chregu82/Atari2600Board/OrigJrBoard/JrBoard/JrBoard.kicad_pcb

## KiCad design OrigJrBoard/JrBoard/JrBoard.kicad_pcb (2021-01-26)

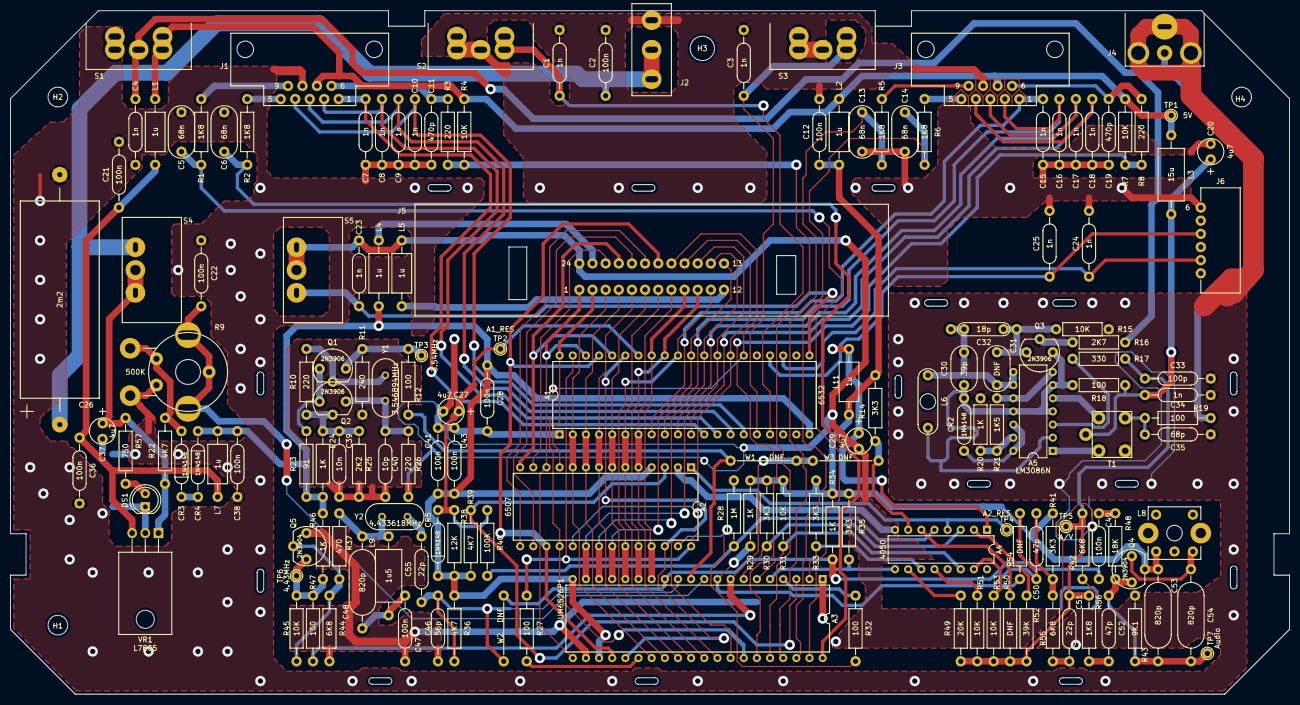
[picture p3: board JrBoard.kicad_pcb from above]

Board: 2 copper layers, 247.0 x 132.0 mm, 162 parts (0 on the bottom side), 115 nets.

Parts:
A1: 6532; DIP-40_W15.24mm
A2: 6507; DIP-28_W15.24mm
A3: UM6526P1; DIP-40_W15.24mm
A4: 4050; DIP-16_W7.62mm
A5: LM3086N; DIP-14_W7.62mm
C1, C3, C4, C7, C8, C9, C10, C15, C16, C17, C18, C23, C24, C25, C34: 1n; C_leg_small
C2, C12, C21, C22, C28, C36, C38, C41, C43, C47, C49: 100n; C_leg_small
C5, C6, C13, C14: 68n; C_oval_big
C11, C19: 470p; C_leg_small
C20, C27, C29, C37: 4u7; CP_small
C26: 2m2; CP_big
C30: 39p; C_oval_small
C31: DNF; C_oval_small
C32: 18p; C_4hole
C33: 100p; C_leg_small
C35: 68p; C_leg_small
C39: 10n; C_leg_small
C40: 10p; C_leg_small
C46: 56p; C_leg_small
C48, C53, C54: 820p; C_leg_big
C50, C52: 47p; C_leg_small
C51, C55: 22p; C_leg_small
CR2: 1N4148; Diode_short
CR3, CR4, CR5: 1N4148; Diode
DS1: LED RED; LED_D5.0mm_Clear
H1, H2, H4: MountingHole; HoleEdge
H3: MountingHole; HoleTop
J1: Joy left; Joystick_conn
J2: DC In; DC_IN
J3: Joy right; Joystick_conn
J4: RF_Out
J5: Cartridge Connector; Cartridge
J6: SEL / RES; Button_conn
L1, L2, L4, L5, L7, L11: 1u; L_small
L3: 15u; L_big
L6: 0..1u; L_var_2pin
L8: 0..4u; L_var_5pin
L9: 1u5; L_big
Q1, Q2, Q3: 2N3906; TR_TO92
Q4, Q5: 2N3904; TR_TO92
R1, R2, R5, R6, R56: 1K8; R0.5Inch
R3, R8, R10, R26: 220; R0.5Inch
R4, R7, R31, R45, R51, R53: 10K; R0.5Inch
R9: 500K; R_Var
R11: 240; R0.5Inch
R12, R19, R27, R32, R47: 100; R0.5Inch
R14, R30, R33, R35, R41: 3K3; R0.5Inch
R15: 10K; R_small
R16: 2K7; R_small
R17: 330; R_small
R18: 100; R_small
R20: 1K; R_small
R21: 1K5; R_small
R22, R36, R39: 4K7; R0.5Inch
R23: 91; R0.5Inch
R24, R29, R34, R46: 1K; R0.5Inch
R25: 2K2; R0.5Inch
R28: 1M; R0.5Inch
R37: 470; R0.5Inch
R38: 12K; R0.5Inch
R40: 100K; R0.5Inch
R42, R44, R55: 6K8; R0.5Inch
R43: 9K1; R0.5Inch
R48: 18K; R0.5Inch
R49: 20K; R0.5Inch
R50, R54: DNF; R0.5Inch
R52: 39K; R0.5Inch
R57: 750; R0.5Inch
S1: CH3/4; Switch_rear
S2: DIFF_L; Switch_rear
S3: DIFF_R; Switch_rear
S4: POWER_SW; Switch_top
S5: COLOR_SW; Switch_top
T1: TV_Trans; Atari_TV_Trans
TP1: 5V; TestPoint_THTPad_D2.0mm_Drill1.0mm
TP2: A1_RES; TestPoint_THTPad_D2.0mm_Drill1.0mm
TP3: 3.54MHz; TestPoint_THTPad_D2.0mm_Drill1.0mm
TP4: A2_RES; TestPoint_THTPad_D2.0mm_Drill1.0mm
TP5: A/V; TestPoint_THTPad_D2.0mm_Drill1.0mm
TP6: 4.43MHz; TestPoint_THTPad_D2.0mm_Drill1.0mm
TP7: Audio; TestPoint_THTPad_D2.0mm_Drill1.0mm
VR1: L7805; TO-220-3_Horizontal_TabDown
W1, W2, W3: DNF; Wire
Y1: 3.546894MHz; Crystal_HC18-U_Vertical
Y2: 4.433618MHz; Crystal_HC18-U_Vertical

Connections:
+5V: J1.7, J3.7, L1.1, L2.1, L3.1, R4.2, R7.2, S1.3, TP1.1
+5VA: C12.1, C53.1, L2.2, L8.1, L11.1, Q4.2, R14.1, R29.1, R30.1, R31.1, R33.1, R34.1, R35.1, R41.1
/A0: A1.7, A2.5, A3.32, J5.8
/A1: A1.6, A2.6, A3.31, J5.7
/A1_R: A1.34, C27.1, CR5.2, R38.2, R40.1, TP2.1
/A2: A1.5, A2.7, A3.30, J5.6
/A2_R: A2.1, A4.4, R28.2, TP4.1
/A3: A1.4, A2.8, A3.29, J5.5
/A4: A1.3, A2.9, A3.28, J5.4
/A5: A1.2, A2.10, A3.27, J5.3
/A6: A1.40, A2.11, J5.2
/A7: A1.38, A2.12, A3.21, J5.1
/A8: A2.13, J5.22
/A9: A1.36, A2.14, J5.21
/A10: A2.15, J5.19
/A11: A2.16, J5.20
/A12: A1.37, A2.17, A3.24, J5.18
/AUD: A3.13, C49.2, R34.2, W2.1
/COL: A3.9, C50.2, R29.2, R54.1
/CSYNC: A3.2, A4.11, R33.2
/D0: A1.33, A2.25, A3.14, J5.9
/D1: A1.32, A2.24, A3.15, J5.10
/D2: A1.31, A2.23, A3.16, J5.11
/D3: A1.30, A2.22, A3.17, J5.13
/D4: A1.29, A2.21, A3.18, J5.14
/D5: A1.28, A2.20, A3.19, J5.15
/D6: A1.27, A2.19, A3.33, J5.16
/D7: A1.26, A2.18, A3.34, J5.17
/I0: A3.40, C6.1, R2.2
/I1: A3.39, C5.1, R1.2
/I2: A3.38, C14.1, R6.2
/I3: A3.37, C13.1, R5.2
/I4: A3.36, R3.2, R4.1
/I5: A3.35, R7.1, R8.2
/LUM0: A3.7, A4.3, R30.2
/LUM1: A3.5, A4.9, R35.2
/LUM2: A3.6, A4.14, R31.2
/OSC: A3.11, R12.2, W1.1
/PA0: A1.8, C15.1, J3.1
/PA1: A1.9, C16.1, J3.2
/PA2: A1.10, C17.1, J3.3
/PA3: A1.11, C18.1, J3.4
/PA4: A1.12, C7.1, J1.1
/PA5: A1.13, C8.1, J1.2
/PA6: A1.14, C9.1, J1.3
/PA7: A1.15, C10.1, J1.4
/PAL-S: A3.12, C46.1, C55.2, R36.2, W2.2
/PB0: A1.24, C25.1, J6.4
/PB1: A1.23, C24.1, J6.2
/PB3: A1.21, C23.1, S5.1
/PB6: A1.17, C1.1, S2.3
/PB7: A1.16, C3.1, S3.3
/RDY: A2.3, A3.3, R39.2
/RW: A1.35, A2.26, A3.25
/o0: A2.27, R32.2
/o2: A1.39, A2.28, R27.2
GND: A1.1, A2.2, A3.1, A3.22, A4.8, C1.2, C2.2, C3.2, C4.2, C5.2, C6.2, C7.2, C8.2, C9.2, C10.2, C11.2, C12.2, C13.2, C14.2, C15.2, C16.2, C17.2, C18.2, C19.2, C20.2, C21.2, C22.2, C23.2, C24.2, C25.2, C26.2, C27.2, C28.2, C29.2, C33.2, C34.2, C35.2, C36.2, C37.2, C38.2, C39.2, C40.2, C41.2, C43.2, C46.2, C47.2, DS1.1, J1.8, J2.G, J3.8, J4.2, J5.24, J6.6, L5.2, Q5.1, R9.3, R11.2, R15.2, R20.2, R25.2, R26.2, R42.2, R43.2, R44.2, S1.1, S2.1, S2.2, S3.1, S3.2, S5.2, S5.3, T1.1, VR1.2
unnamed: A1.20, A2.4, A3.20, A3.23, C28.1, C38.1, C41.1, C43.1, CR4.1, CR5.1, L4.1, L7.2, R23.1, R24.1, R36.1, R38.1, R39.1, R46.1
unnamed: A3.4, R32.1
unnamed: A3.8, R47.1, W1.2, W3.1
unnamed: A3.10, C22.1, R9.2
unnamed: A3.26, R27.1
unnamed: A4.1, C29.1, L11.2
unnamed: A4.2, R52.2
unnamed: A4.5, R28.1, R40.2
unnamed: A4.6, R50.2
unnamed: A4.7, R14.2, W3.2
unnamed: A4.10, R49.2
unnamed: A4.12, R51.2
unnamed: A4.15, R53.2, R54.2
unnamed: A5.1, T1.2
unnamed: A5.3, R17.1
unnamed: A5.5, T1.4
unnamed: A5.8, A5.9, C30.1, C31.2, C32.2, L6.1
unnamed: A5.7, A5.10, R21.1
unnamed: A5.2, A5.4, A5.6, A5.11, C30.2, CR2.2, L6.2, Q3.1, R18.2
unnamed: A5.12, A5.14, CR2.1
unnamed: A5.13, R20.1, R21.2
unnamed: C2.1, C26.1, J2.S, J2.T, S4.3
unnamed: C4.1, R16.2, S1.2
unnamed: C11.1, J1.6, R3.1
unnamed: C19.1, J3.6, R8.1
unnamed: C20.1, C34.1, L3.2, R18.1, T1.3
unnamed: C31.1, C32.1, Q3.3, R15.1
unnamed: C33.1, C51.1, R17.2, R42.1, R49.1, R50.1, R51.1, R52.1, R53.1, R56.1, TP5.1
unnamed: C35.1, R19.1, T1.5
unnamed: C37.1, R22.1, R57.1, S4.1, S4.2, VR1.1
unnamed: C39.1, Q2.2, R10.2, R24.2, R25.1
unnamed: C40.1, Q2.3, R26.1, Y1.2
unnamed: C47.1, C48.2, L9.2
unnamed: C48.1, L9.1, R37.2, Y2.1
unnamed: C49.1, R48.2
unnamed: C50.1, R41.2, R55.2
unnamed: C51.2, R55.1
unnamed: C52.1, R56.2
unnamed: C52.2, C53.2, C54.1, Q4.1, R43.1, R48.1, TP7.1
unnamed: C54.2, L8.2, Q4.3
unnamed: C55.1, Y2.2
unnamed: CR3.1, CR4.2
unnamed: CR3.2, R9.1, R22.2
unnamed: DS1.2, R57.2
unnamed: J1.5, R2.1
unnamed: J1.9, R1.1
unnamed: J3.5, R6.1
unnamed: J3.9, R5.1
unnamed: J4.1, R19.2
unnamed: J5.12, L5.1
unnamed: J5.23, L4.2
unnamed: Q1.1, Q2.1, R23.2
unnamed: Q1.2, R10.1, Y1.1
unnamed: Q1.3, R11.1, R12.1, TP3.1
unnamed: Q3.2, R16.1
unnamed: Q5.2, R37.1, R44.1, R45.2
unnamed: Q5.3, R45.1, R46.2, R47.2, TP6.1
VCC: C21.1, C36.1, L1.2, L7.1, VR1.3
