chregu82/Atari2600Board/ModdedJrBoard/JrBoard.sch

## KiCad design ModdedJrBoard/JrBoard.sch (2021-01-05)

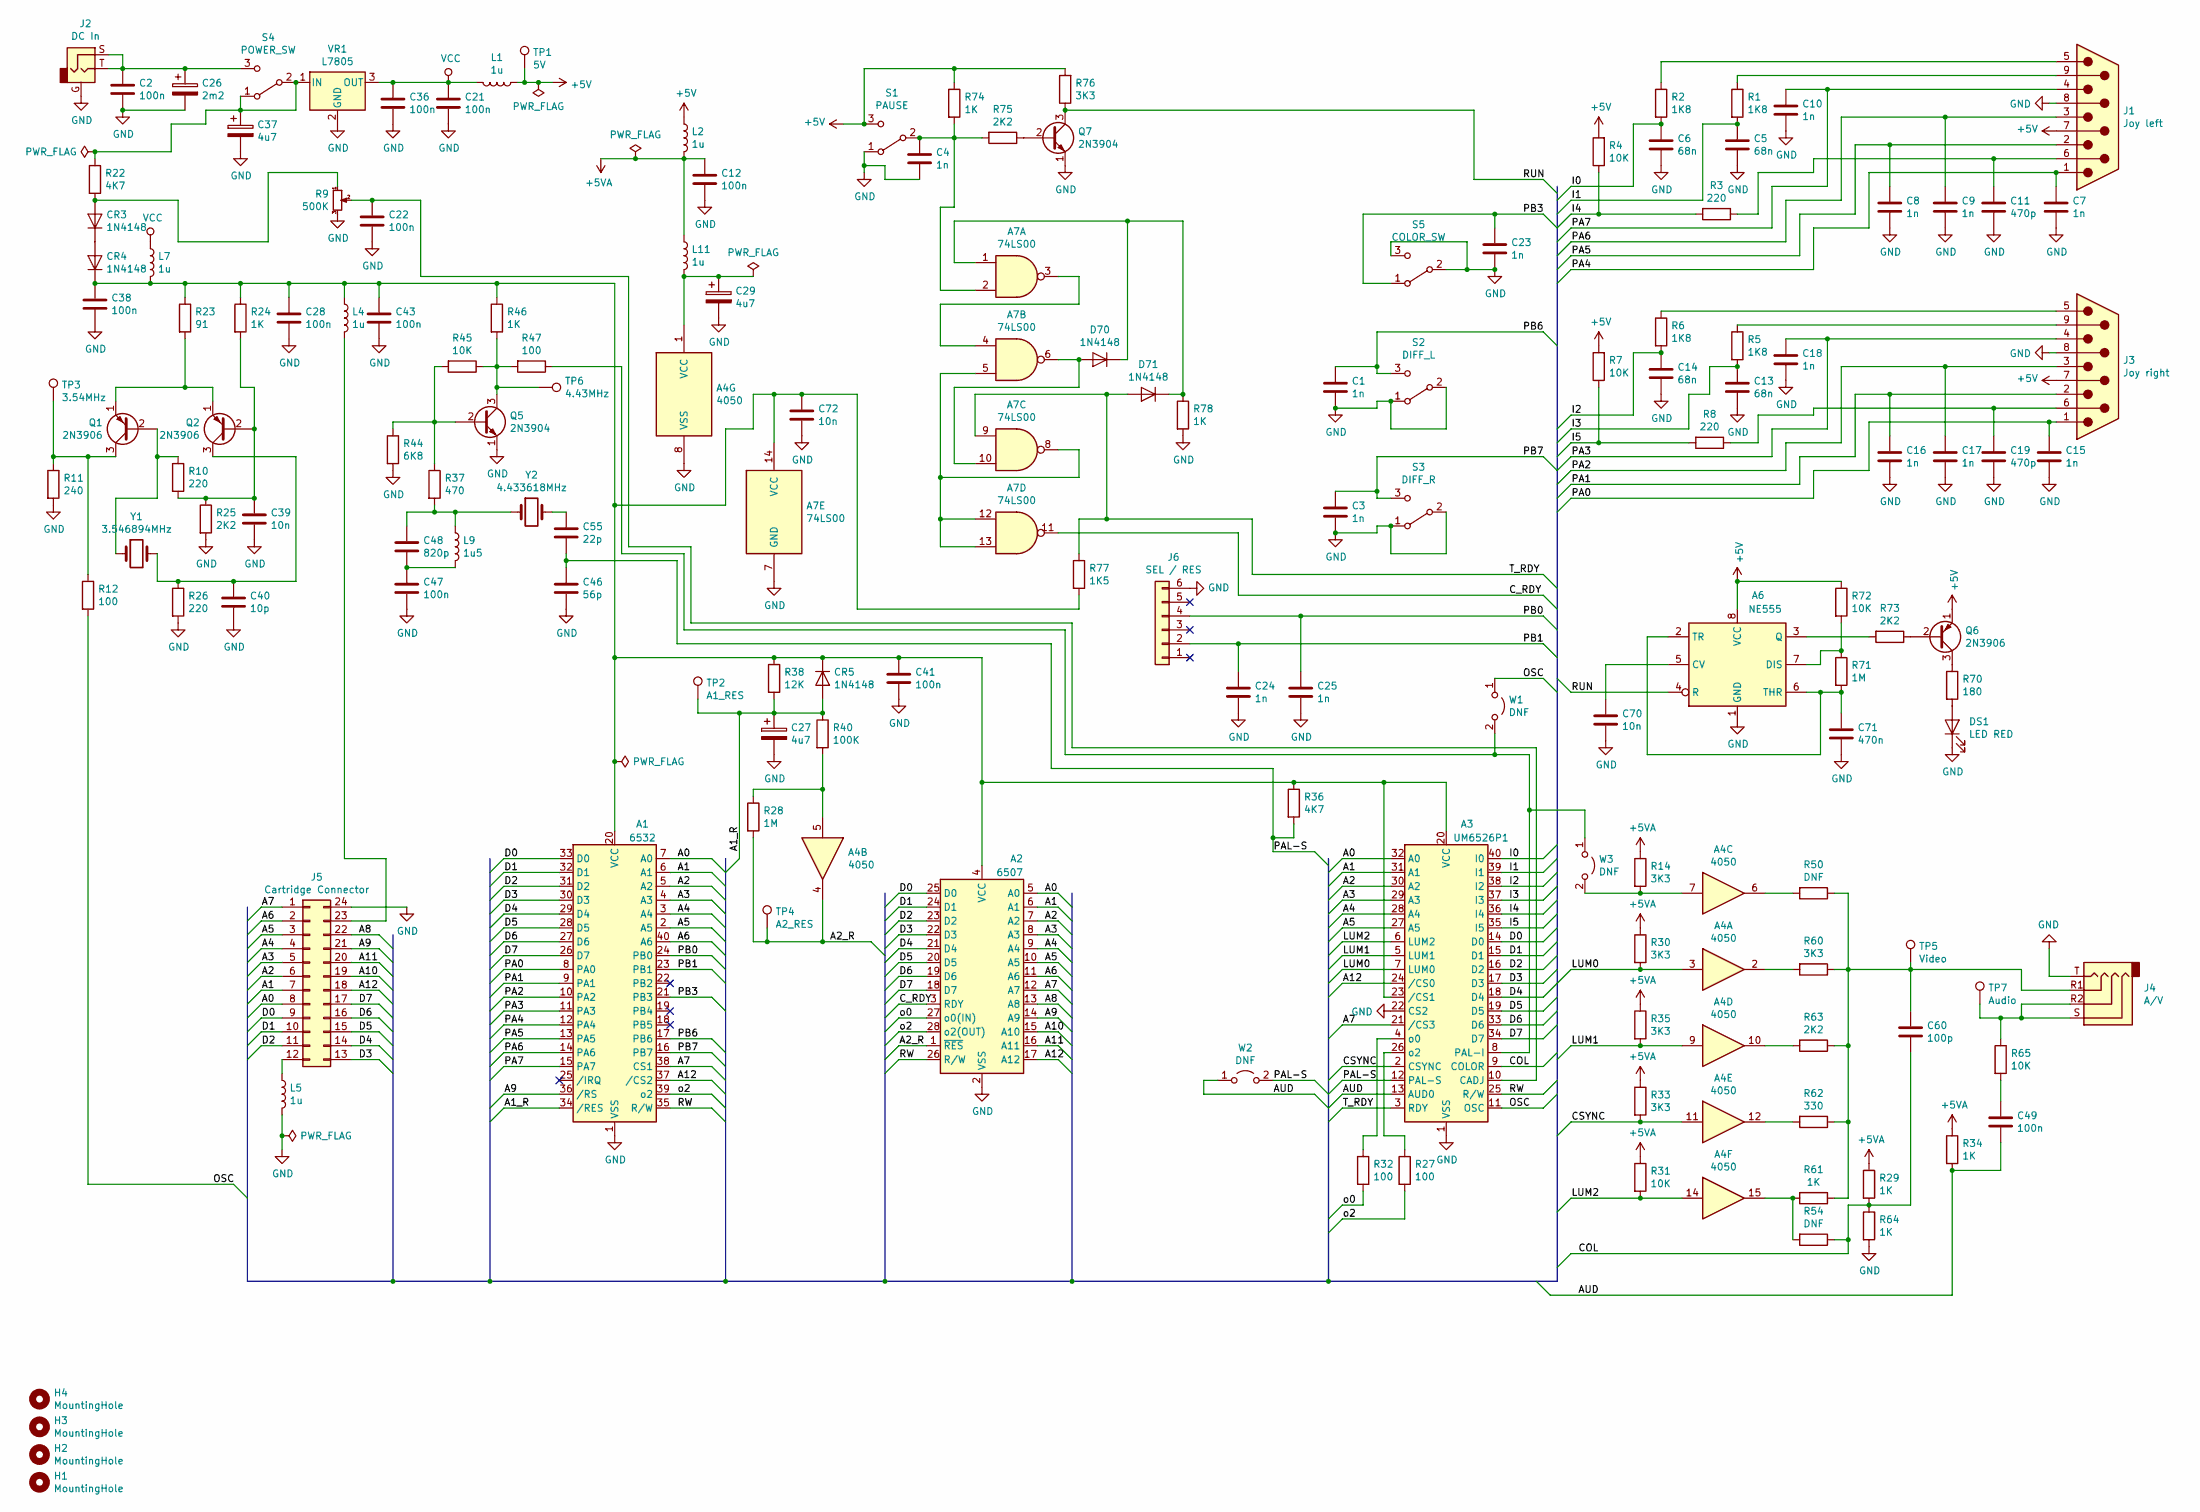
[picture p4: schematic JrBoard.sch]

Parts:
A1: 6532; DIP-40_W15.24mm
A2: 6507; DIP-28_W15.24mm
A3: UM6526P1; DIP-40_W15.24mm
A4: 4050; DIP-16_W7.62mm
A6: NE555; DIP-8_W7.62mm
A7: 74LS00; DIP-14_W7.62mm
C1, C3, C4, C7, C8, C9, C10, C15, C16, C17, C18, C23, C24, C25: 1n; C_leg_small
C2, C12, C21, C22, C28, C36, C38, C41, C43, C47, C49: 100n; C_leg_small
C5, C6, C13, C14: 68n; C_oval_big
C11, C19: 470p; C_leg_small
C26: 2m2; CP_big
C27, C29, C37: 4u7; CP_small
C39, C70, C72: 10n; C_leg_small
C40: 10p; C_leg_small
C46: 56p; C_leg_small
C48: 820p; C_leg_big
C55: 22p; C_leg_small
C60: 100p; C_leg_small
C71: 470n; C_leg_small
CR3, CR4, CR5: 1N4148; Diode
D70, D71: 1N4148; Diode
DS1: LED RED; LED_D5.0mm_Clear
H1, H2, H4: MountingHole; HoleEdge
H3: MountingHole; HoleTop
J1: Joy left; Joystick_conn
J2: DC In; DC_IN
J3: Joy right; Joystick_conn
J4: A/V; 4PoleJack
J5: Cartridge Connector; Cartridge
J6: SEL / RES; Button_conn
L1, L2, L4, L5, L7, L11: 1u; L_small
L9: 1u5; L_big
Q1, Q2, Q6: 2N3906; TR_TO92
Q5, Q7: 2N3904; TR_TO92
R1, R2, R5, R6: 1K8; R0.5Inch
R3, R8, R10, R26: 220; R0.5Inch
R4, R7, R31, R45, R65, R72: 10K; R0.5Inch
R9: 500K; R_Var
R11: 240; R0.5Inch
R12, R27, R32, R47: 100; R0.5Inch
R14, R30, R33, R35, R60, R76: 3K3; R0.5Inch
R22, R36: 4K7; R0.5Inch
R23: 91; R0.5Inch
R24, R29, R34, R46, R61, R64, R74, R78: 1K; R0.5Inch
R25, R63, R73, R75: 2K2; R0.5Inch
R28, R71: 1M; R0.5Inch
R37: 470; R0.5Inch
R38: 12K; R0.5Inch
R40: 100K; R0.5Inch
R44: 6K8; R0.5Inch
R50, R54: DNF; R0.5Inch
R62: 330; R0.5Inch
R70: 180; R0.5Inch
R77: 1K5; R0.5Inch
S1: PAUSE; Switch_rear
S2: DIFF_L; Switch_rear
S3: DIFF_R; Switch_rear
S4: POWER_SW; Switch_top
S5: COLOR_SW; Switch_top
TP1: 5V; TestPoint_THTPad_D2.0mm_Drill1.0mm
TP2: A1_RES; TestPoint_THTPad_D2.0mm_Drill1.0mm
TP3: 3.54MHz; TestPoint_THTPad_D2.0mm_Drill1.0mm
TP4: A2_RES; TestPoint_THTPad_D2.0mm_Drill1.0mm
TP5: Video; TestPoint_THTPad_D2.0mm_Drill1.0mm
TP6: 4.43MHz; TestPoint_THTPad_D2.0mm_Drill1.0mm
TP7: Audio; TestPoint_THTPad_D2.0mm_Drill1.0mm
VR1: L7805; TO-220-3_Horizontal_TabDown
W1, W2, W3: DNF; Wire
Y1: 3.546894MHz; Crystal_HC18-U_Vertical
Y2: 4.433618MHz; Crystal_HC18-U_Vertical

Connections:
+5V: A6.8 (VCC), J1.7, J3.7, L1.1, L2.1, Q6.1 (E), R4.2, R7.2, R72.1, R74.1, R76.2, S1.3 (C), TP1.1
+5VA: C12.1, L2.2, L11.1, R14.1, R29.1, R30.1, R31.1, R33.1, R34.1, R35.1
A0: A1.7 (A0), A2.5 (A0), A3.32 (A0), J5.8
A1: A1.6 (A1), A2.6 (A1), A3.31 (A1), J5.7
A1_R: A1.34 (/RES), C27.1, CR5.2 (A), R38.2, R40.1, TP2.1
A2: A1.5 (A2), A2.7 (A2), A3.30 (A2), J5.6
A2_R: A2.1 (~RES), A4.4, R28.2, TP4.1
A3: A1.4 (A3), A2.8 (A3), A3.29 (A3), J5.5
A4: A1.3 (A4), A2.9 (A4), A3.28 (A4), J5.4
A5: A1.2 (A5), A2.10 (A5), A3.27 (A5), J5.3
A6: A1.40 (A6), A2.11 (A6), J5.2
A7: A1.38 (CS1), A2.12 (A7), A3.21 (/CS3), J5.1
A8: A2.13 (A8), J5.22
A9: A1.36 (/RS), A2.14 (A9), J5.21
A10: A2.15 (A10), J5.19
A11: A2.16 (A11), J5.20
A12: A1.37 (/CS2), A2.17 (A12), A3.24 (/CS0), J5.18
AUD: A3.13 (AUD0), C49.2, R34.2, W2.1 (A)
COL: A3.9 (COLOR), C60.2, R29.2, R54.1, R64.1
CSYNC: A3.2 (CSYNC), A4.11, R33.2
C_RDY: A2.3 (RDY), A7.11
D0: A1.33 (D0), A2.25 (D0), A3.14 (D0), J5.9
D1: A1.32 (D1), A2.24 (D1), A3.15 (D1), J5.10
D2: A1.31 (D2), A2.23 (D2), A3.16 (D2), J5.11
D3: A1.30 (D3), A2.22 (D3), A3.17 (D3), J5.13
D4: A1.29 (D4), A2.21 (D4), A3.18 (D4), J5.14
D5: A1.28 (D5), A2.20 (D5), A3.19 (D5), J5.15
D6: A1.27 (D6), A2.19 (D6), A3.33 (D6), J5.16
D7: A1.26 (D7), A2.18 (D7), A3.34 (D7), J5.17
GND: A1.1 (VSS), A2.2 (VSS), A3.1 (VSS), A3.22 (CS2), A4.8 (VSS), A6.1 (GND), A7.7 (GND), C1.2, C2.2, C3.2, C4.2, C5.2, C6.2, C7.2, C8.2, C9.2, C10.2, C11.2, C12.2, C13.2, C14.2, C15.2, C16.2, C17.2, C18.2, C19.2, C21.2, C22.2, C23.2, C24.2, C25.2, C26.2, C27.2, C28.2, C29.2, C36.2, C37.2, C38.2, C39.2, C40.2, C41.2, C43.2, C46.2, C47.2, C70.2, C71.2, C72.2, DS1.1 (K), J1.8, J2.G, J3.8, J4.T, J5.24, J6.6, L5.2, Q5.1 (E), Q7.1 (E), R9.3, R11.2, R25.2, R26.2, R44.2, R64.2, R78.2, S1.1 (A), S2.1 (A), S2.2 (B), S3.1 (A), S3.2 (B), S5.2 (B), S5.3 (C), VR1.2 (GND)
I0: A3.40 (I0), C6.1, R2.2
I1: A3.39 (I1), C5.1, R1.2
I2: A3.38 (I2), C14.1, R6.2
I3: A3.37 (I3), C13.1, R5.2
I4: A3.36 (I4), R3.2, R4.1
I5: A3.35 (I5), R7.1, R8.2
LUM0: A3.7 (LUM0), A4.3, R30.2
LUM1: A3.5 (LUM1), A4.9, R35.2
LUM2: A3.6 (LUM2), A4.14, R31.2
unnamed: A1.20 (VCC), A2.4 (VCC), A3.20 (VCC), A3.23 (/CS1), A7.14 (VCC), C28.1, C38.1, C41.1, C43.1, C72.1, CR4.1 (K), CR5.1 (K), L4.1, L7.2, R23.1, R24.1, R36.1, R38.1, R46.1, R77.2
unnamed: A3.4 (o0), R32.1
unnamed: A3.8 (PAL-I), R47.1, W1.2 (B), W3.1 (A)
unnamed: A3.10 (CADJ), C22.1, R9.2
unnamed: A3.26 (o2), R27.1
unnamed: A4.1 (VCC), C29.1, L11.2
unnamed: A4.2, R60.2
unnamed: A4.5, R28.1, R40.2
unnamed: A4.6, R50.2
unnamed: A4.7, R14.2, W3.2 (B)
unnamed: A4.10, R63.2
unnamed: A4.12, R62.2
unnamed: A4.15, R54.2, R61.2
unnamed: A6.2 (TR), A6.6 (THR), C71.1, R71.2
unnamed: A6.3 (Q), R73.2
unnamed: A6.5 (CV), C70.1
unnamed: A6.7 (DIS), R71.1, R72.2
unnamed: A7.1, D70.1 (K), D71.1 (K), R78.1
unnamed: A7.2, C4.1, R74.2, R75.2, S1.2 (B)
unnamed: A7.3, A7.4
unnamed: A7.6, A7.10, D70.2 (A)
unnamed: A7.5, A7.8, A7.12, A7.13
unnamed: C2.1, C26.1, J2.S, J2.T, S4.3 (C)
unnamed: C11.1, J1.6, R3.1
unnamed: C19.1, J3.6, R8.1
unnamed: C37.1, R22.1, S4.1 (A), S4.2 (B), VR1.1 (IN)
unnamed: C39.1, Q2.2 (B), R10.2, R24.2, R25.1
unnamed: C40.1, Q2.3 (C), R26.1, Y1.2
unnamed: C47.1, C48.2, L9.2
unnamed: C48.1, L9.1, R37.2, Y2.1
unnamed: C49.1, R65.2
unnamed: C55.1, Y2.2
unnamed: C60.1, J4.R1, R50.1, R60.1, R61.1, R62.1, R63.1, TP5.1
unnamed: CR3.1 (K), CR4.2 (A)
unnamed: CR3.2 (A), R9.1, R22.2
unnamed: DS1.2 (A), R70.2
unnamed: J1.5, R2.1
unnamed: J1.9, R1.1
unnamed: J3.5, R6.1
unnamed: J3.9, R5.1
unnamed: J4.R2, J4.S, R65.1, TP7.1
unnamed: J5.12, L5.1
unnamed: J5.23, L4.2
unnamed: Q1.1 (E), Q2.1 (E), R23.2
unnamed: Q1.2 (B), R10.1, Y1.1
unnamed: Q1.3 (C), R11.1, R12.1, TP3.1
unnamed: Q5.2 (B), R37.1, R44.1, R45.2
unnamed: Q5.3 (C), R45.1, R46.2, R47.2, TP6.1
unnamed: Q6.2 (B), R73.1
unnamed: Q6.3 (C), R70.1
unnamed: Q7.2 (B), R75.1
OSC: A3.11 (OSC), R12.2, W1.1 (A)
PA0: A1.8 (PA0), C15.1, J3.1
PA1: A1.9 (PA1), C16.1, J3.2
PA2: A1.10 (PA2), C17.1, J3.3
PA3: A1.11 (PA3), C18.1, J3.4
PA4: A1.12 (PA4), C7.1, J1.1
PA5: A1.13 (PA5), C8.1, J1.2
PA6: A1.14 (PA6), C9.1, J1.3
PA7: A1.15 (PA7), C10.1, J1.4
PAL-S: A3.12 (PAL-S), C46.1, C55.2, R36.2, W2.2 (B)
PB0: A1.24 (PB0), C25.1, J6.4
PB1: A1.23 (PB1), C24.1, J6.2
PB3: A1.21 (PB3), C23.1, S5.1 (A)
PB6: A1.17 (PB6), C1.1, S2.3 (C)
PB7: A1.16 (PB7), C3.1, S3.3 (C)
RUN: A6.4 (R), Q7.3 (C), R76.1
RW: A1.35 (R/W), A2.26 (R/W), A3.25 (R/W)
T_RDY: A3.3 (RDY), A7.9, D71.2 (A), R77.1
VCC: C21.1, C36.1, L1.2, L7.1, VR1.3 (OUT)
o0: A2.27 (o0(IN)), R32.2
o2: A1.39 (o2), A2.28 (o2(OUT)), R27.2
