chregu82/Atari2600Board/(commit log)

2020-12-07 Final parts list original board
2020-12-09 Working on schematic
    [JrBoard.kicad_pcb, JrBoard.sch]
2020-12-13 Continued schematic
    [JrBoard.sch]
2020-12-14 finished schematic
    [JrBoard.sch]
2020-12-14 Started PCB
    [JrBoard.kicad_pcb, JrBoard.sch]
2020-12-15 PCB work
    [JrBoard.kicad_pcb, JrBoard.sch]
2020-12-18 PCB top mostly done
    [JrBoard.kicad_pcb, JrBoard.sch]
2020-12-20 Finished PCB
    [JrBoard.kicad_pcb, JrBoard.sch]
2020-12-20 Added Gerber files, going to production
    [JrBoard-B_Cu.gbr, JrBoard-B_Mask.gbr, JrBoard-B_Paste.gbr, JrBoard-B_SilkS.gbr, JrBoard-Edge_Cuts.gbr, JrBoard-F_Cu.gbr, JrBoard-F_Mask.gbr, JrBoard-F_Paste.gbr]
2021-01-02 Trying to build a board with Composite and Pause Mod
    [JrBoard-B_Cu.gbr, JrBoard-B_Mask.gbr, JrBoard-B_Paste.gbr, JrBoard-B_SilkS.gbr, JrBoard-Edge_Cuts.gbr, JrBoard-F_Cu.gbr, JrBoard-F_Mask.gbr, JrBoard-F_Paste.gbr]
2021-01-02 Schematic corrections
    [JrBoard-B_Cu.gbr, JrBoard-B_Mask.gbr, JrBoard-B_Paste.gbr, JrBoard-B_SilkS.gbr, JrBoard-Edge_Cuts.gbr, JrBoard-F_Cu.gbr, JrBoard-F_Mask.gbr, JrBoard-F_Paste.gbr]
2021-01-05 Right footprints for diode
    [JrBoard.kicad_pcb, JrBoard.sch]
2021-01-05 Corrections after first production
    [JrBoard.kicad_pcb]
2021-01-06 PCB corrections
    [JrBoard.kicad_pcb]
2021-01-10 New gerber files
    [JrBoard-B_Cu.gbr, JrBoard-B_Mask.gbr, JrBoard-B_Paste.gbr, JrBoard-B_SilkS.gbr, JrBoard-Edge_Cuts.gbr, JrBoard-F_Cu.gbr, JrBoard-F_Mask.gbr, JrBoard-F_Paste.gbr]
2021-01-26 Minor corrections
    [JrBoard.kicad_pcb, JrBoard.sch]
