chregu82/Atari2600Board/OrigJrBoard/top.jpg

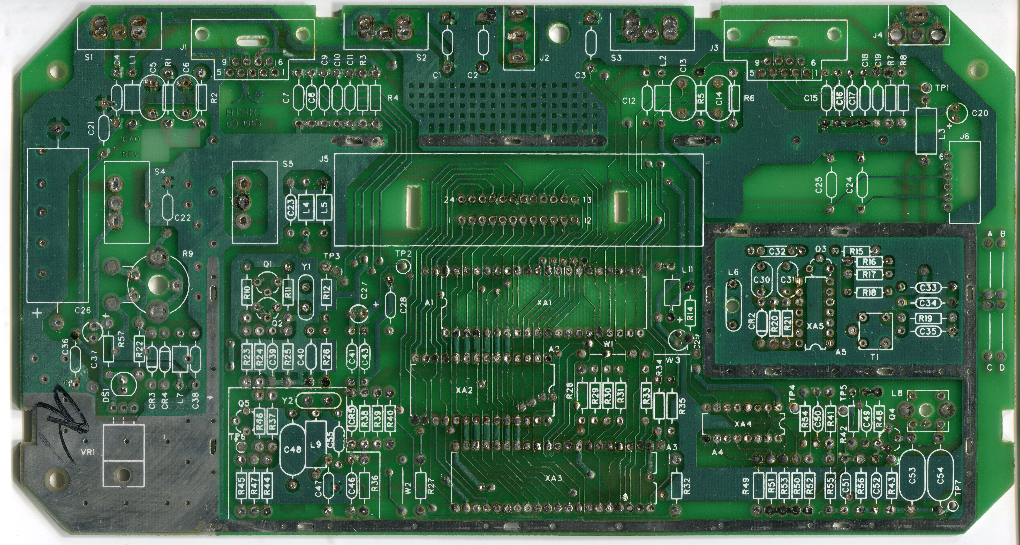
OrigJrBoard/top.jpg
