chregu82/Atari2600Board/OrigJrBoard/bottom.jpg

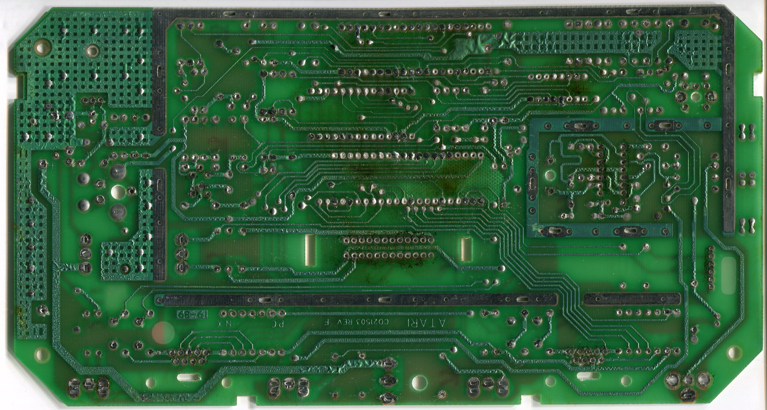
OrigJrBoard/bottom.jpg
